honza-zemlicka/DE2-project/images/buttons.png

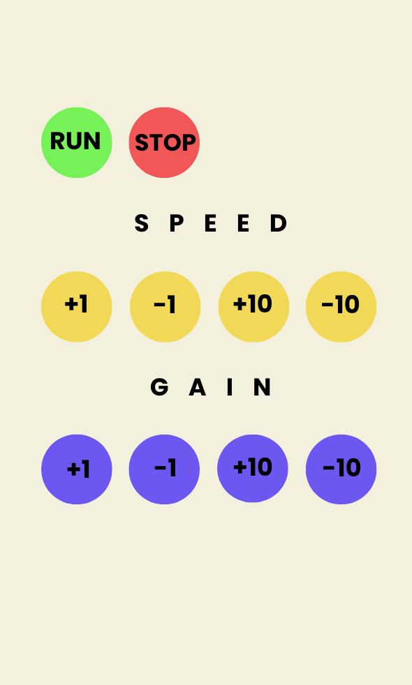
images/buttons.png
