honza-zemlicka/DE2-project/images/robot_IR_sensor.jpg

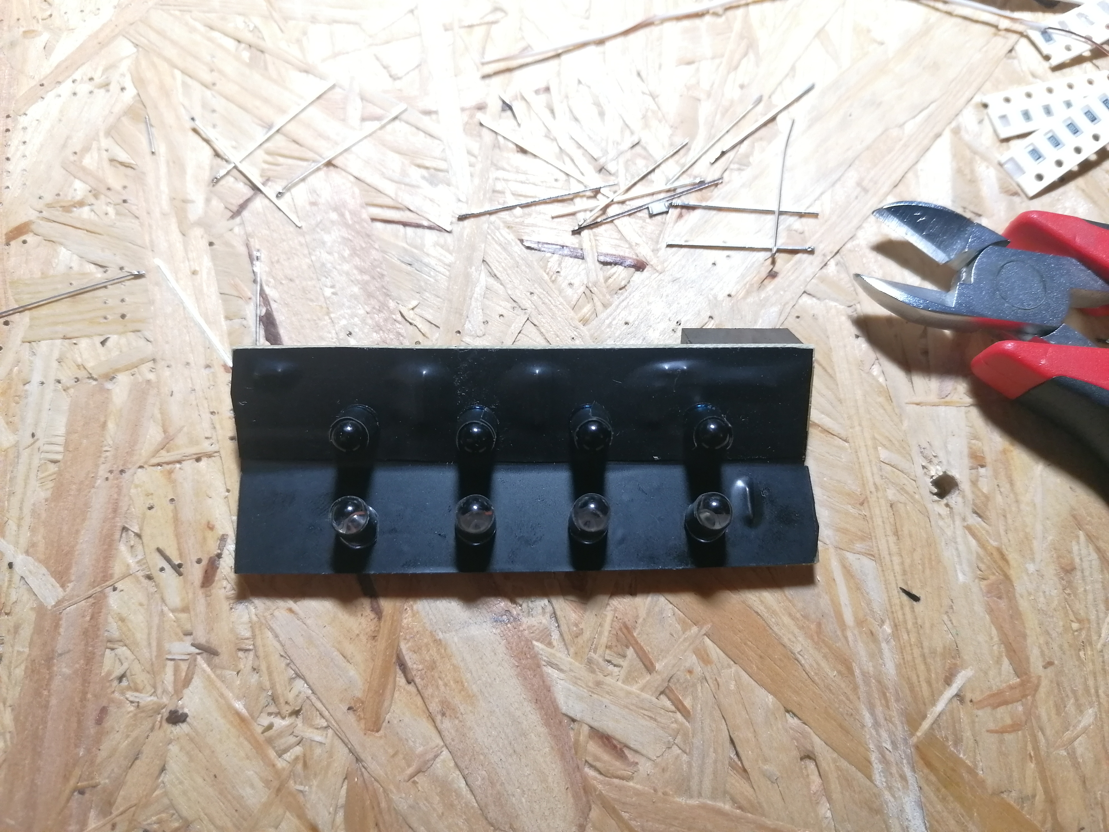
images/robot_IR_sensor.jpg
