honza-zemlicka/DE2-project/images/robot_pcb.jpg

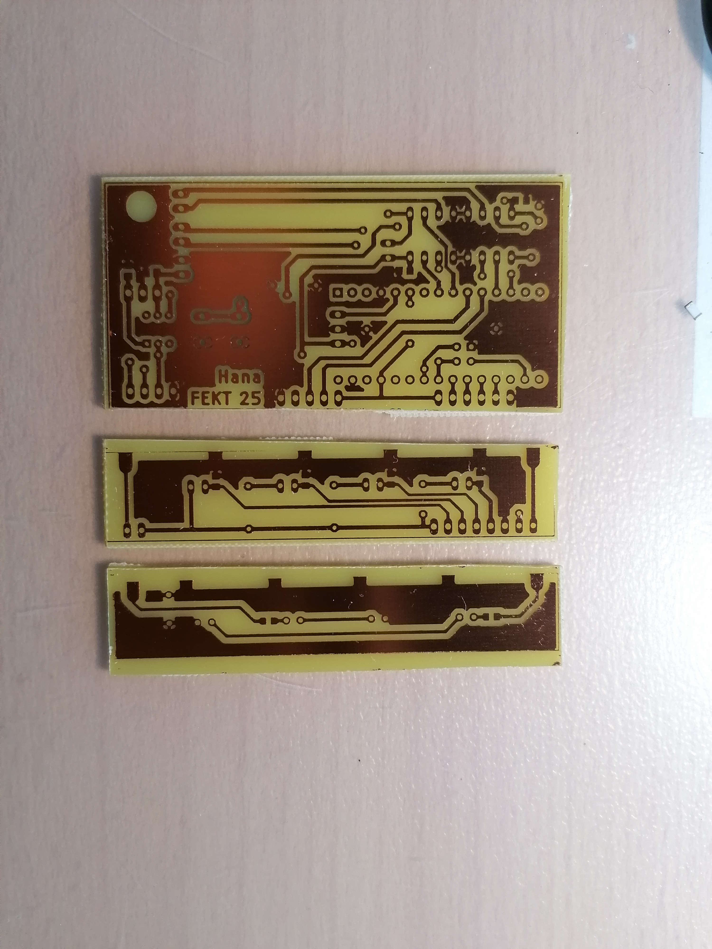
images/robot_pcb.jpg
