honza-zemlicka/DE2-project/DE2-project_final/src/main.c

// -Eppur si muove-        line-follower v02-02

#include <avr/io.h>        // AVR device-specific IO definitions
#include <avr/interrupt.h> // Interrupts standard C library for AVR-GCC
#include <stdio.h>
#include <stdbool.h>
#include <gpio.h>
#include <util/delay.h>
#include <oled.h>
#include <ultrasound.h>
#include "robot_definitions.h"

// Calibration variables
uint16_t S1K[2] = {0, 0}; // [0] = White (Max), [1] = Black (Min)
uint16_t S2K[2] = {0, 0};
uint16_t S3K[2] = {0, 0};
uint16_t S4K[2] = {0, 0};

// Regulator parameters
int16_t error, correction;

// Robot parameters and variables
uint16_t S1, S2, S3, S4;
uint8_t motor_speed = 100;
uint8_t gain_kp = 2;
_Bool robot_run = 1;
uint8_t *p_robot_run = &robot_run;

char display_buffer[16];

// Variables used in ISR
volatile uint8_t calib_tick = 0;
volatile uint8_t count = 0;

volatile uint32_t ir_data = 0;
volatile uint8_t bit_index = 0;
volatile uint32_t frame_received = 0;
volatile uint8_t rx_bytes = 0;
volatile uint8_t last_time = 0;
volatile uint8_t measured = 0;
volatile uint8_t length = 0;
volatile uint8_t reception_complete = 0;

const char *encode_cmd(uint8_t command);

void auto_calibration();
static inline int16_t map(int16_t x, int16_t in_min, int16_t in_max, int16_t out_min, int16_t out_max);
static int16_t constrain(int16_t val, uint8_t min, uint8_t max);

int main(void)
{
  // Set I/O pins
  gpio_mode_output(&DDRD, MOTOR_LF);
  gpio_mode_output(&DDRD, MOTOR_RF);
  gpio_mode_output(&DDRB, MOTOR_LB);
  gpio_mode_output(&DDRB, MOTOR_RB);
  gpio_mode_output(&DDRB, USER_LED);

  gpio_mode_input(&DDRC, SENSOR_CR);
  gpio_mode_input(&DDRC, SENSOR_CL);
  gpio_mode_input(&DDRC, SENSOR_RR);
  gpio_mode_input(&DDRC, SENSOR_LL);
  gpio_mode_input_pullup(&DDRD, BUTTON);

  // Timer and interrupt pin INT0 init
  timer2_init();
  int0_init();
  sei();

  // init and set I2C and OLED
  twi_init();
  oled_init(OLED_DISP_ON);
  oled_clrscr();
  oled_charMode(DOUBLESIZE);

  oled_gotoxy(0, 0);
  oled_puts("Kp    =");
  oled_gotoxy(0, 2);
  oled_puts("Speed =");
  update_display();

  adc_init();
  ultrasound_init();

  pwm_init();
  pwm_write(&PORTD, MOTOR_LF, 0);
  pwm_write(&PORTD, MOTOR_RF, 0);
  pwm_write(&PORTB, MOTOR_LB, 0);
  pwm_write(&PORTB, MOTOR_RB, 0);

  _delay_ms(800);
  auto_calibration();

  while (1)
  {

    if (robot_run == 1)
    {
      S1 = map(analog_read(SENSOR_CR), S1K[1], S1K[0], 0, 100);   // Read and normalize analog values
      S2 = map(analog_read(SENSOR_CL), S2K[1], S2K[0], 0, 100);
      S3 = map(analog_read(SENSOR_RR), S3K[1], S3K[0], 0, 100);
      S4 = map(analog_read(SENSOR_LL), S4K[1], S4K[0], 0, 100);

      // Proportional regulator
      error = S2 - S1;
      correction = error * gain_kp;

      pwm_write(&PORTD, MOTOR_LF, constrain(motor_speed + correction, 0, 130));   // Write PWM to motors
      pwm_write(&PORTD, MOTOR_RF, constrain(motor_speed - correction, 0, 130));

      if (count == 20)    // Measuring distance every 320ms
      {
        uint16_t distance = ultrasound_read(); // Measured distance in mm

        if (distance > 0 && distance < 75)  // is obstacle closer than 7,5 cm
        {
          dodge_object(); // init avoidance maneuver
        }
        count = 0; // Clear counter
      }
    }
    else    // stopping the robot (robot_run = 0)
    {
      pwm_write(&PORTD, MOTOR_LF, 0);
      pwm_write(&PORTD, MOTOR_RF, 0);
      gpio_write_high(&PORTB, USER_LED);
    }

    gpio_write_low(&PORTB, USER_LED);

    if (gpio_read(&PIND, BUTTON) == 0)    // is button pressed?
    {
      debounce();
      robot_run = !robot_run;  // toggle robot state (run/stop)
    }
  }
  return 0;
}

const char *encode_cmd(uint8_t command)
{
  switch (command)
  {
    // ROBOT COMMANDS

  case RUN:
    *p_robot_run = 1;
    break;

  case STOP:
    *p_robot_run = 0;
    break;

    // DISPLAY COMMANDS

  case GAIN_PLUS_1:
    return gain_kp += 1;

  case GAIN_MINUS_1:
    return gain_kp -= 1;

  case GAIN_PLUS_10:
    return gain_kp += 10;

  case GAIN_MINUS_10:
    return gain_kp -= 10;

  case SPEED_PLUS_1:
    return motor_speed += 1;

  case SPEED_MINUS_1:
    return motor_speed -= 1;

  case SPEED_PLUS_10:
    return motor_speed += 10;

  case SPEED_MINUS_10:
    return motor_speed -= 10;
  }
}

// VOID

void int0_init()
{
  EICRA = (1 << ISC01) | (1 << ISC00); // INT0 = rising edge
  EIMSK = (1 << INT0);                 // enable INT0
}

void timer2_init()
{
  TCCR2A = 0;                                       // normal mode
  TCCR2B = (1 << CS22) | (1 << CS21) | (1 << CS20); // prescaler 1024, 64us
  TIMSK2 |= (1 << TOIE2);                           // enable overflow
  TCNT2 = 0;
}

void debounce()
{
  _delay_ms(10);
  while (gpio_read(&PIND, BUTTON) == 0)
  {
    _delay_ms(10);
  }
}

void auto_calibration()
{
  gpio_write_high(&PORTB, USER_LED);

  S1K[0] = S1K[1] = analog_read(SENSOR_CR);   // Read analog values from IR sensor
  S2K[0] = S2K[1] = analog_read(SENSOR_CL);
  S3K[0] = S3K[1] = analog_read(SENSOR_RR);
  S4K[0] = S4K[1] = analog_read(SENSOR_LL);

  calib_tick = 0;

  while (calib_tick < 150) // calibration loop
  {
    pwm_write(&PORTB, MOTOR_LB, 150); // rotate robot
    pwm_write(&PORTD, MOTOR_RF, 150);

    S1 = analog_read(SENSOR_CR);
    S2 = analog_read(SENSOR_CL);
    S3 = analog_read(SENSOR_RR);
    S4 = analog_read(SENSOR_LL);

    // Search for max (white) and min (black) value
    // SxK[0] - white
    // SxK[1] - black

    if (S1 > S1K[0])
      S1K[0] = S1;
    else if (S1 < S1K[1])
      S1K[1] = S1;

    if (S2 > S2K[0])
      S2K[0] = S2;
    else if (S2 < S2K[1])
      S2K[1] = S2;

    if (S3 > S3K[0])
      S3K[0] = S3;
    else if (S3 < S3K[1])
      S3K[1] = S3;

    if (S4 > S4K[0])
      S4K[0] = S4;
    else if (S4 < S4K[1])
      S4K[1] = S4;
  }

  // align robot to line
  do
  {
    pwm_write(&PORTD, MOTOR_LB, 100);
    pwm_write(&PORTD, MOTOR_RF, 100);

    S1 = map(analog_read(SENSOR_CR), S1K[1], S1K[0], 0, 100);
    S2 = map(analog_read(SENSOR_CL), S2K[1], S2K[0], 0, 100);

  } while (S1 > 50); // stop when sensor sees the line

  pwm_write(&PORTB, MOTOR_LB, 0);
  pwm_write(&PORTD, MOTOR_RF, 0);

  while (1)   // Waiting for button press to start run
  {
    if (gpio_read(&PIND, BUTTON) == 0)
    {
      debounce();
      gpio_write_low(&PORTB, USER_LED);
      break;
    }
  }
}

void dodge_object(void)
{
  gpio_write_high(&PORTB, USER_LED);

  // Turn 90 degrees right
  pwm_write(&PORTD, MOTOR_LF, 30);
  pwm_write(&PORTD, MOTOR_RF, 120);
  _delay_ms(1000);

  // Drive around the obstacle
  pwm_write(&PORTD, MOTOR_LF, 120);
  pwm_write(&PORTD, MOTOR_RF, 95);

  _delay_ms(200);
  
  // Continue until line is found
  do
  {
    pwm_write(&PORTD, MOTOR_LF, 100);
    pwm_write(&PORTD, MOTOR_RF, 75);

    S1 = map(analog_read(SENSOR_CR), S1K[1], S1K[0], 0, 100);
    S2 = map(analog_read(SENSOR_CL), S2K[1], S2K[0], 0, 100);

  } while ((S2 > 30) || (S1 > 30));

  // Align back2line
  pwm_write(&PORTD, MOTOR_LF, 30);
  pwm_write(&PORTD, MOTOR_RF, 120);
  _delay_ms(350);

  gpio_write_low(&PORTB, USER_LED);
}

void update_display()
{
  oled_gotoxy(17, 0);
  sprintf(display_buffer, "%2d", gain_kp);
  oled_puts(display_buffer);

  oled_gotoxy(15, 2);
  sprintf(display_buffer, "%3d", motor_speed);
  oled_puts(display_buffer);

  oled_display();
}

void encode_frame()
{
  uint8_t delay_ir = 0;
  while (1)
  {
    if (reception_complete == 1)
    {
      // NEC format decoding:
      uint8_t address = (ir_data >> 24) & 0xFF;     // [31..24] Address
      uint8_t address_inv = (ir_data >> 16) & 0xFF; // [23..16] Address_inv
      uint8_t command = (ir_data >> 8) & 0xFF;      // [15..8]  Command
      uint8_t command_inv = (ir_data >> 0) & 0xFF;  // [7..0]   Command_inv

      // Validity check
      if ((command ^ command_inv) == 0xFF)
      {
        const char *msg = encode_cmd(command);
        update_display();
      }

      reception_complete = 0;
      delay_ir = 0;
    }

    // Timeout for NEC repeat codes
    if (TIFR2 & (1 << TOV2)) // Timer2 overflow occurred
    {
      delay_ir++;
      TIFR2 |= (1 << TOV2); // clear flag by writing 1
    }

    if (delay_ir == 3)
    {
      EIFR |= (1 << INTF0); // clear interrupt flag
      EIMSK = (1 << INT0);  // enable INT0
      return;
    }
  }
}

// ISR

ISR(TIMER2_OVF_vect)
{
  calib_tick++;
  count++;
}

ISR(INT0_vect)
{
  uint8_t measured = TCNT2;
  uint8_t length = measured - last_time;

  // NEC Start bit
  if (length > 60 && length < 100) // 5 062 us / 64 = 79 tics
  {
    ir_data = 0;
    bit_index = 0;
    frame_received = 0;
  }

  // HIGH
  if (length > 25 && length < 45) // 2 249 us / 64 = 35 tics
  {
    // ir_data |= (1 << bit_index);
    ir_data <<= 1;
    ir_data |= 1;
    bit_index++;
  }

  // LOW
  if (length > 7 && length < 25) // 1 124 us / 64 = 17,5 tics
  {
    // ir_data |= (0 << bit_index);
    ir_data <<= 1;
    bit_index++;
  }

  if (bit_index == frame_length)    // received all frames?
  {
    EIMSK &= ~(1 << INT0); // disable INT0
    rx_bytes++;

    TCNT2 = 0;
    reception_complete = 1;
    encode_frame();
  }
  last_time = measured;
}

// STATIC

static int16_t constrain(int16_t val, uint8_t min, uint8_t max)   // cropp value
{
  uint8_t motor = 0;
  if (val <= min)
    motor = min;
  else if (val >= max)
    motor = max;
  else
    motor = val;
  return motor;
}

static inline int16_t map(int16_t x, int16_t in_min, int16_t in_max, int16_t out_min, int16_t out_max)    // Normalize values
{
  return (int32_t)(x - in_min) * (out_max - out_min) / (in_max - in_min) + out_min;
}
