honza-zemlicka/DE2-project/(commit log)

2025-12-01 Added flowcharts and block diagram
2025-12-01 Changed flowcharts size
2025-12-01 Edited flowchart descriptions
2025-12-09 Track movement + dodge
2025-12-09 constrain edited, robot follows the track
2025-12-10 flowchart update
2025-12-10 Resized calib flowchart
